MonkeyMan1911/rp-person-tracker/models/jackolantern_topper.stl

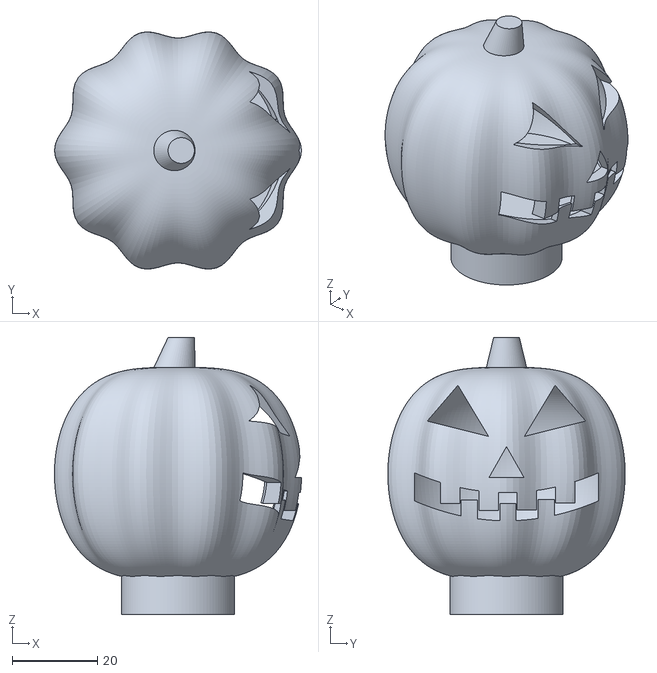
[picture p1: CAD file, 2026-10-27]
models/jackolantern_topper.stl
58.0 x 55.7 x 65.0
