MonkeyMan1911/rp-person-tracker/models/lid_and_box.stl

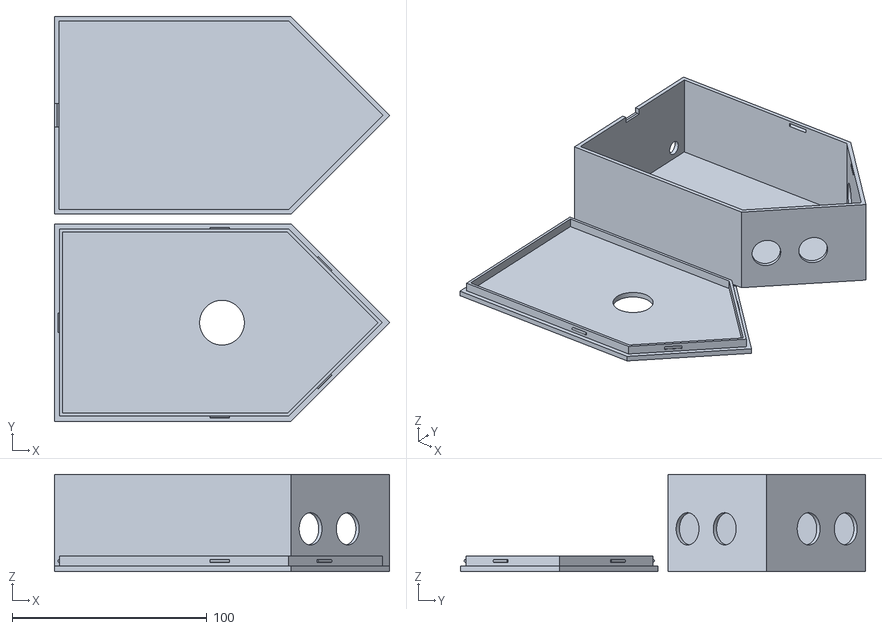
[picture p2: CAD file, 2026-10-19]
models/lid_and_box.stl
172.4 x 208.2 x 50.0
