MonkeyMan1911/rp-person-tracker/scripts/measurements.txt

05cm - 0.08494999
10cm - 0.16785
15cm - 0.224200016
20cm - 0.27024996
25cm - 0.37630004
30cm - 0.413400032
35cm - 0.52155
40cm - 0.57375
45cm - 0.624
50cm - 0.689799936
55cm - 0.75625
60cm - 0.844
65cm - 0.91744995
70cm - 0.9666501
75cm - 1.04145
80cm - 1.1076
85cm - 1.1786
90cm - 1.2411499
95cm - ~2 but no consistent averages
