MonkeyMan1911/rp-person-tracker/(commit log)

2026-10-15 Inital commit
    [lid_and_box.stl]
2026-10-15 Rename 'stls' to 'models' folder
    [lid_and_box.stl]
2026-10-19 Adjusted dimensions of lid and box
    [lid_and_box.stl]
2026-10-22 Fixed servo's return to 0 if nothing is detected
    [main.py]
2026-10-23 Changed out rotational for positional servo. Updated README to come soon
2026-10-24 Updated README for use of positional servo
2026-10-27 Added jack-o-lantern topper
    [jackolantern_topper.stl]
